Hypfer/esp8266-vindriktning-particle-sensor/(threads)

Thread 1 (2021-07-17):

Temperature and Humidity

GSzabados, 2021-07-17:
Hello,

First of all, awesome project. I didn’t even know that IKEA has an Air Quality sensor. Some might would think that they would fit inside their Air purifier first a sensor like this...

Anyhow, have you thought of adding a Temperature and Humidity sensor into the device to give a full range of environmental details? Like a DTH22 or AM2302. Is there enough space to fir that as well?

Best Regards,

Gábor

Hypfer, 2021-07-19:
As I personally already have a functioning bunch of zigbee temperature sensors basically everywhere, I did not try that, however it should be an easy modification software-wise.

As for hardware, it might get a bit too crammed in there.
Note that adding too much stuff in there might interfere with the airflow and therefore mess up the readings

GSzabados, 2021-07-19:
> Note that adding too much stuff in there might interfere with the airflow and therefore mess up the readings

Thanks for the reply. I've just had some time this morning and checked the images of the device from Twitter. I understand now what you mean regarding the airflow. Anyhow I will give it a try with a DTH22 HAT. I ordered this morning before checking the pictures. I will keep you updated how it worked out. (I might will need some help for the sketch as I don't have too much experience with it.)

Hypfer, 2021-07-19:
If you want to extend this codebase, you probably would want to do the following

Extend that state struct to also contain the data from the DHT22
https://github.com/Hypfer/esp8266-vindriktning-particle-sensor/blob/320cdc01117ec18da23eded5a7450d70119d8cdd/src/types.h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

Extend the autoconfig section to also publish temperature and humidity sensors

https://github.com/Hypfer/esp8266-vindriktning-particle-sensor/blob/320cdc01117ec18da23eded5a7450d70119d8cdd/src/esp8266-vindriktning-particle-sensor.ino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

Extend the MQTT publish function to add the other measurements to the published JSON

https://github.com/Hypfer/esp8266-vindriktning-particle-sensor/blob/320cdc01117ec18da23eded5a7450d70119d8cdd/src/esp8266-vindriktning-particle-sensor.ino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

And since the DHT22 requires polling afaik, extend the loop function to poll it on each publish

https://github.com/Hypfer/esp8266-vindriktning-particle-sensor/blob/320cdc01117ec18da23eded5a7450d70119d8cdd/src/esp8266-vindriktning-particle-sensor.ino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

That should be about it

matrob, 2021-08-16:
The additional function of the DHT22 would be absolutely great. Is anyone already working on this?

GSzabados, 2021-08-16:
> The additional function of the DHT22 would be absolutely great. Is anyone already working on this?

I went down the ESPHome way at the end as @Habbie made a ESPHome component which is/will be part of the latest release of ESPHome.

matrob, 2021-08-16:
Thank you for pointing this out. I will take a closer look at his PR https://github.com/esphome/esphome/pull/2038.

unreal4u, 2021-08-16:
Hi all!

Based on above indications of @Hypfer (hey, thanks for your work!), I created a quick-'n-dirty© commit that implements a DHT11 sensor. Please adjust accordingly if you are using the DHT22 variant :)

I connected it to D4 of the Wemos Mini, or GPIO02, adjust accordingly.

Because it is so quick and dirty, I won't create a PR: ideally I would want to define one variable in order to include all the additional information + libraries and such, but this is the first time I have played with an ESP8266 board, so I def. will have done some very wrong stuff!

The commit can be found at my fork:
https://github.com/unreal4u/esp8266-vindriktning-particle-sensor/tree/support-for-dht-sensor

To compile, you'll need the Adafruit Unified Sensor (v1.1.4) library installed. I also installed the DHT Sensor Library (v1.4.2) but I'm not quite sure if this is needed or not.

grmcdorman, 2021-12-30:
I have an alternative firmware implementation, https://github.com/grmcdorman/esp8266_vindriktning; this uses an SHT31-D (an I2C device), but it shouldn't be hard to add the DHT variants to the code base from the way I've structured it. I have it working nicely with the SHT31-D.

The Vindriktning polling in that code has been gently revised; I believe it is more robust (for example, that 25 ms wait "for unknown reasons" isn't needed any more).

Closed 2021-07-21.

Thread 2 (2021-07-17):

Crash after first reading is received

joelhaasnoot, 2021-07-17:
Thanks for this excellent work!

I tried to replicate but after receiving the first reading, the system crashes. A side-effect of this is that the Wifi Config is lost and you have to reconfigure it, making debugging a bit of a pain :)

The serial log looks like this:
```
IP: 192.168.1.239
-- Current GPIO Configuration --
PIN_UART_RX: 4
Receiving:................................................................Receiving:....................Done.
Received PM 2.5 reading: 6

--------------- CUT HERE FOR EXCEPTION DECODER ---------------

Exception (0):
epc1=0x40201673 epc2=0x00000000 epc3=0x00000000 excvaddr=0x00000000 depc=0x00000000

>>>stack>>>

ctx: cont
sp: 3ffffdc0 end: 3fffffc0 offset: 0190
3fffff50:  3ffef6a8 3ffef9a4 00000004 40201673
3fffff60:  40217c3d 0000000f 00000000 00000000
3fffff70:  3ffef6a8 3ffef720 3ffef1c0 402037cc
3fffff80:  00000000 00000000 00000001 3ffefb34
3fffff90:  3fffdad0 00000000 3ffefb20 40203800
3fffffa0:  3fffdad0 00000000 3ffefb20 40217640
3fffffb0:  feefeffe feefeffe 3ffe862c 4010156d
<<<stack<<<

--------------- CUT HERE FOR EXCEPTION DECODER ---------------
```

I've decoded the exception to be

```
Exception 0: Illegal instruction
PC: 0x40201673
EXCVADDR: 0x00000000

Decoding stack results
0x40217c3d: __delay(unsigned long) at /Users/user/Library/Arduino15/packages/esp8266/hardware/esp8266/3.0.1/cores/esp8266/core_esp8266_wiring.cpp line 55
0x402037cc: handleUart() at /Users/user/Downloads/esp8266-vindriktning-particle-sensor-master/src/esp8266-vindriktning-particle-sensor/serialCommunication.ino line 81
0x40203800: loop() at /Users/user/Downloads/esp8266-vindriktning-particle-sensor-master/src/esp8266-vindriktning-particle-sensor/esp8266-vindriktning-particle-sensor.ino line 142
0x40217640: loop_wrapper() at /Users/user/Library/Arduino15/packages/esp8266/hardware/esp8266/3.0.1/cores/esp8266/core_esp8266_main.cpp line 201
```

(using a D1 Mini Pro)
Any ideas what's going wrong?

joelhaasnoot, 2021-07-17:
Ah, took a little longer and figure it out. Once I had downgraded to ESP8266 Board/Core version 2.7.4 it works fine.

It does however still seem to constantly be losing its wifi settings.

Hypfer, 2021-07-19:
Huh. Interesting. Unfortunately, I can't say much about both of your issues since I honestly lack the experience.

Which version of ESP8266 Board/Core were you using before? Maybe there are breaking changes mentioned in the release notes between 2.7.4 and that version.

In any case lets hope that someone with the suitable skills reads this issue and shines some light on the problem

joelhaasnoot, 2021-07-21:
I used 3.0.1 before.
I think the issue may be timing related. It seems to be quite sensitive timing wise, see my other message.

joelhaasnoot, 2021-07-21:
> It does however still seem to constantly be losing its wifi settings.
This was an issue on my side

enwi, 2021-07-22:
I think both issues (#2 and #8) are related to the `parseState()` function, which was declared to return a bool, but did not return anywhere, which will result in undefined behaviour. This has been fixed with #9 and I think it is already working for @joelhaasnoot again.

https://github.com/Hypfer/esp8266-vindriktning-particle-sensor/blob/e6ff884dfb68036f855f042d9b4e05165366b09d/src/serialCommunication.ino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

Hypfer, 2021-07-23:
Thanks for figuring that out @enwi !

As I just copy-pasted most of this code from one project to another, the same issue did surface here:
https://github.com/Hypfer/esp8266-midea-dehumidifier/commit/fabc01297fe6c787b87e095390be8abcaafbc91c

I am somewhat surprised that the compiler didn't complain though

enwi, 2021-07-23:
@Hypfer C compilers can sometimes be strange. I mean I didn't even get a compiler warning, so I first thought the `memcpy` did something weird. But it wasn't until I tried to force the function to return by adding a return statement that the static analysis (intellisense) told me, hey you can't just return you need to return a boolean that I noticed it.

Closed 2021-07-24.

Thread 3 (2021-07-19):

reading calculation appears to be wrong

Habbie, 2021-07-19:
https://github.com/Hypfer/esp8266-vindriktning-particle-sensor/blob/master/src/serialCommunication.ino#L2
says

```
serialRxBuf[3] * 256 ^ 3 + serialRxBuf[4] * 256 ^ 2 + serialRxBuf[5] * 256 ^ 1 + serialRxBuf[6];
```

which I believe is equivalent to

```
serialRxBuf[3] * 256 ^ (3 + serialRxBuf[4]) * 256 ^ (2 + serialRxBuf[5]) * 256 ^ (1 + serialRxBuf[6]);
```

The code is most certainly not multiplying [3] by '256 to the power of 3', etc.

I think the right code would be

```
serialRxBuf[5] * 256 + serialRxBuf[6];
```

based on page 7 of http://www.jdscompany.co.kr/download.asp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

Hypfer, 2021-07-19:
Ah yes I was somewhat suspecting that that could be wrong but did work anyways as during normal operation only the last byte actually contains data.

Adding [3] and [4] to the sum as well was taken from the [datasheet of the PM2107](https://9b54c437a0e032d4eb32-010f1da83de0c62ea8c11f5612b46edb.ssl.cf3.rackcdn.com/Cubic_PM2107_DS.pdf) as I did only find a different datasheet for the PM1006K which used a different poll command than the one for the PM1006.
By googling for "11 02 0b 01 e1", the PM2107 turned up.

Measurements would be absurdly high to exceed those two bytes though so it makes sense that they've dropped(?) that

Habbie, 2021-07-19:
Yep - the wrong code effectively adds 2 to the measurement I think, which is not an error that stands out! I did also find the PM1006K - at least that explains why the string is so long for just 2 bytes of data :-)

Habbie, 2021-07-19:
Commit looks good, thanks for the quick response!

Hypfer, 2021-07-19:
I can't help but wonder what the other data fields might contain 🤔

I did plot DF9-DF12 for a while and got basically the same curve as the PM2.5 reading albeit offset by around 20 μg/m³ so I'd suspect that that's some kind of raw uncalibrated value or similar.

DF5-DF8 are mostly constant during my observations

Habbie, 2021-07-19:
Yes, me too! I did not plot them but I do have this small collection of dumps

```
16 11 0b 00 00 00 17 00 00 06 9f 00 00 00 16 01 00 00 00 fb

16 11 0b 00 00 00 19 00 00 06 a4 00 00 00 18 01 00 00 00 f2

16 11 0b 00 00 00 18 00 00 06 a3 00 00 00 17 01 00 00 00 f5
```

(I used these to implement checksumming, not for anything else).

The offset in these 3 readings is 1, not 20.

I also note that the PM1006K, which does have PM10 and PM1.0, still has a shorter string!

Habbie, 2021-07-19:
Going even more off topic, you inspired me to do https://github.com/esphome/esphome/pull/2038, with credit to you in the comment there, and in the docs content at https://github.com/esphome/esphome-docs/pull/1315

Hypfer, 2021-07-20:
This might also be interesting for @GSzabados #1

GSzabados, 2021-07-20:
Thanks @Hypfer, and @Habbie that is awesome work. I haven't started to use EspHome yet, but that will make things far more easier.

Hypfer, 2021-07-20:
If only ESPHome wasn't using yaml and this weird web thing :(

GSzabados, 2021-07-20:
> If only ESPHome wasn't using yaml and this weird web thing :(

Sure thing, but with a HA installation it makes things kinda plug and play.

blakadder, 2021-08-28:
https://en.gassensor.com.cn/Product_files/Specifications/LED%20Particle%20Sensor%20PM1006K%20Specification.pdf

Habbie, 2021-08-28:
The sensor in the IKEA VINDRIKTNING is the PM1006, not the PM1006K.

Closed 2021-07-19.

Thread 4 (2021-07-20):

Not an issue - just a question! ZigBee instead?

LaurenceGough, 2021-07-20:
Hi, thanks for the project, very clever idea, and an interesting device.

I did purchase one of these sensors today, I didn't even realise it had a fan, quite a noisy one at that! You're right, without the fan operating such as generating some smoke behind it it doesn't detect it at all, but as soon as the fan turns on it does just fine. I do wondering if lowering the voltage on the fan gives the same accuracy, because I sure am tempted! Doing some very caveman style testing shows it's very accurate so far.

There is some interesting info on the sensor if it is this one. Interesting the range of PM it can detect, not just 2.5um particles, unless this is a custom modification made! I wonder if it can detect grass pollen at around 20um
https://pdf.directindustry.com/pdf/cubic-sensor-instrument-co-ltd/pm1006k-led-particle-sensor-module/54752-927719-_4.html

Anyway, onto my question - if I wished to do a similar mod but using ZigBee (Smartthings hub) rather than WiFi would you have any suggestions?

This devices begs for smart connectivity, I can't believe Ikea did not do this with their already established ZigBee range!

There is nothing wrong with WiFi of course, it'd work great. I'm just a fan of ZigBee for low data rate/low powered devices.

Many thanks

Hypfer, 2021-07-20:
I'm not aware of any zigbee-capable uCs that are as easy to work with as the esp8266.
I'm sure that there must be _something_ but it will either be expensive or hard to work with or maybe even both.

This is made worse by the fact that the SmartThings Hub is a proprietary thing which you cannot extend and/or debug in any way.
It wouldn't surprise me if they also have a whitelist of allowed devices.

I am not an expert on zigbee devices, however looking at both the [ZCL](https://www.nxp.com/docs/en/reference-manual/ZCLRM.pdf) as well as the [ZHA](https://www.nxp.com/docs/en/user-guide/JN-UG-3076.pdf) spec there doesn't seem to be some existing structure for air quality measurements.

If I understand it correctly, in theory it should be possible to extend ZCL with custom functionality. However as you don't control the code of your Zigbee coordinator, this is definitely impossible.

MattWestb, 2021-08-29:
Sorry for jumping in but Starkvind that is being reeled in October is having one Zigbee module (the new EFR32MG21) and the OTA firmware is released and can being flashed on other EFR32MG21 devices.
I see 2 version they can have doing it:
1. Using the vindriktning PCB and the debug connection for "sniffing" the sensor and using the fan connection (not populated on the PCB) for steering the fan speed (if not loading one different firmware in the MCU).
2. Making one new PCB and have connecting the sensor to it and have one power supply and circuits for PWM steering of the fan (for the purifier) and also the steering knob and is using the Zigbee module MCU for doing all work.

Very likely they have implanting the Zigbee cluster for all relevant data transmitted to there host system and the RX from the sensor and perhaps sending the commands for doing the measuring if not using the vindriktnings PCB.

Closed 2021-07-24.

Thread 5 (2021-07-20):

Not an issue but a suggestion: Merge into Esphome?

oopsitsaflame, 2021-07-20:
Hi, would it be possible to get this device supported into esphome? I think it would fit quite good as a supported sensor and you would get all the other stuff esphome supports as a bonus.

Hypfer, 2021-07-20:
@habbie already did that
See https://github.com/Hypfer/esp8266-vindriktning-particle-sensor/issues/3#issuecomment-882858203

Personally, I don't use ESPHome due to philosophical differences.

Hypfer, 2021-07-20:
Just for reference, I'd like to mention that decentralization is a good thing.
We shouldn't be merging everything into a single yaml behemoth.

Nabu Casa is slowly eating the smarthome world which by definition is a bad thing even though their intentions are most likely good.
We need better solutions to eliminating boilerplate code than merging everything into a single legal entity.

oopsitsaflame, 2021-07-20:
Just for reference too ;) I'd like to mention that while your concerns are understandable., I just like not having to rely on projects where I have to search half the internet for and then to discover that the one dude/duddette who  maintained it alone has last logged in 4 years ago. (not talking about you, but in general). Open source can help with both these problems but not eleminate them completely.
https://xkcd.com/2347/

Closed 2021-07-20.

Thread 10 (2021-07-21):

Question about wiring points

wizbowes, 2021-07-21:
The photo you have of the wired up test points, you seem to have the data wire connected to the test point labelled 'REST'.  Just confirming that this is correct.  Isn't REST a reset line of some kind, and the far left test point labelled ISPDA the data test point?  Or is the board labelling incorrect.  Don't have a scope so can't really check myself...

Hypfer, 2021-07-21:
Yes that is correct.

The board looks like it might've also been used in a different configuration. I suspect that that's why the label isn't UART_TX or something like that.

trejan, 2021-07-23:
The labels don't match normal operation functions because those test points are for in-circuit programming of the uC. It needs ISPCL, ISPDA, MRSTN (REST), VDD and VSS which are all present in that row. The MRSTN pin is configured to be UART RX.

drthanwho, 2023-01-15:
Is there any chance that by accidentally first using ISPDA instead of REST that the board was damaged? I confused myself and connected D2 to ISPDA, realised because was getting an `unknown` value, connected it to REST but still getting no values

Closed 2021-07-21.

Thread 6 (2021-07-21):

Not an issue: but a link to the actual PM1006 datasheet

theOzzieRat, 2021-07-21:
Cubic's website sucks and it doesn't make it clear that there are both PM1006 and PM1006K versions of the sensor that pretty much look identical. I found a link to the PM1006 datasheet which appears to match the data that I have seen posted elsewhere.
The PM1006 only does pm2.5 :(

[(http://www.jdscompany.co.kr/download.asp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)]

Closed 2021-07-24.

Thread 7 (2021-07-21):

Not an issue - A little more information about the fan

sermayoral, 2021-07-21:
Hi. First of all, thanks for this amazing project! I really want to do it, and during the analysis, I had some questions regarding the fan.

If I understand correctly, the firmware of the Ikea board toggle the fan every minute. Surely the firmware does a reading with the fan on. The doubt is the next one: If you replace the 5v output of the ikea board for the 3v3 output of the esp. Does the toogle function hold? Or would you have a fan that is always running?

Thanks

Hypfer, 2021-07-21:
That results in the fan running constantly as it completely bypasses the FAN outputs of the Ikea PCB

sermayoral, 2021-07-21:
Thanks @Hypfer.

What do you think about applying a step down to the FAN outputs of the Ikea PCB in order to reduce voltage to 3.3V? In that way the toggle function should work.

Hypfer, 2021-07-21:
That would require more hardware. The permanent 3.3V were just there for the taking
I wasn't able to spot any downsides of running the fan continuously

Actually I'm more worried about the 5V UART to the 3.3V ESP8266 regarding long-term reliability
Only time will tell

sermayoral, 2021-07-21:
Thanks @Hypfer for the information. I will test with the step down and I will share the results here :-)

Habbie, 2021-08-16:
> Actually I'm more worried about the 5V UART to the 3.3V ESP8266 regarding long-term reliability

I did extensive Googling on this and it appears the ESP8266 UART is 5V safe for receiving.

trlafleur, 2021-10-02:
I use a ~470ohm resistor from the IKEA to the Wemos-D1 Mini pin D7 (GPIO-13) with a surface mount Schottky diode (they have a low V-Forward drop) from D7 with its cathode connected to +3.3v, this clamp the voltage to 3.3V + V-forward drop of the diode... this makes it safer for the ESP8266 (I now see 3.7V on my unit on D7)... Using pin D7 makes it an easy fit for the diode to 3.3v pin on the Wemos-D1 circuit board. ( 3.3v - D8 - D7 ......) so the diode is set on top of D8, with just enough room to solder it to 3.3V and D7.

onshisan, 2022-01-01:
> Just as a note: I move my unit from this codebase to Tasmota

Sounds great, I was also thinking of adding more so I'm curious... any notable issues to report using Tasmota to accomplish this?

trlafleur, 2022-01-01:
useing an esp32, works just fine....

~~ _/) ~~~~ _/) ~~~~ _/) ~~~~ _/) ~~

Tom Lafleur

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

Thread 12 (2021-07-24):

Potential problem with running the fan at 3.3V?

Leeev, 2021-07-24:
I think there may be an issue with running the fan at 3.3V.
At 5V the fan will push a certain CFM for certain amount of time.
At 3.3V the fan will push much less CFM for that time.
The sensor unit counts the number of particles that are pushed though it in that time.
Net result, the sensor will see many less particles (due to less volume of air passing through it) and will under report the air quality.

Hypfer, 2021-07-24:
> The sensor unit counts the number of particles that are pushed though it in that time.

Nope. It counts the particles in the air that it sees. As they are distributed evenly in every m³ of air, the measurement is not impacted. At least I couldn't see any difference in readings when put side by side.

It is possible that the sensor will react slightly slower to changing conditions though, as on change, the new amount of particles may not be distributed as evenly. That however is a temporary state that resolves itself pretty quick.

Hypfer, 2021-07-24:
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

It is still rather quick to react IMO. Someone in the neighbourhood started to burn something just now

Leeev, 2021-07-27:
I see what you're saying, but I think you may be incorrect. The firmware in the unit is calibrated to a full fan speed.
At full speed the fan could move, say, 100cm3 of air through the unit, in say,10 secs. If there are 1000 particles in that 100cm3 of air the unit will register 1000 particles.
If the fan is working at 3.3V, it will move, say, 2/3 of that 100cm3 of air through the sensor in those 10 secs and therefore only register 666 particles.
This would suggest that the air is 'better quality' that it really is?
I'm not say it won't work, but rather the data will be low/incorrect.

Hypfer, 2021-07-27:
As discussed on hackaday I'd argue that that is not the case as there is no mention of the fan and/or its requirements in the datasheet of the sensor.

The fan is not part of the sensor but something that was bolted on by Ikea.
Therefore, I find it hard to believe that anything _inside_ the sensor depends on something purely external

Closed 2021-07-24.

Thread 13 (2021-07-26):

increase max mqtt password

itsme9, 2021-07-26:
hi, could you increase the max mqtt password from 24 to 32 chars please?
I tried to do it myself but get: "Socket error on client <unknown>, disconnecting" in Home assistant so I probably messed it up.
Thanks

binaryhellstorm, 2021-12-29:
Same issue. My password get's truncated after the first 24 characters

onshisan, 2022-01-01:
Also came here to request this. My use case is [Adafruit.io](https://io.adafruit.com/api/docs/mqtt.html#client-libraries) where a 32 char key is used as MQTT password.

Thread 15 (2021-07-30):

UART levels 5V / 3.3V

bertmelis, 2021-07-30:
You write in your readme `"ESP8266 is 5V-tolerant, this should there shouldn't be any issues"`. This is not true of course. Anything aboce 3.6V can damage the pins.

Since the UART level of an PM1006 is I do expect issues with burning pins on the ESP8266.

Maybe the IKEA board has a level shifter? Did you find one?

Hypfer, 2021-07-30:
> This is not true of course. Anything aboce 3.6V can damage the pins.

https://twitter.com/ba0sh1/status/759239169071837184

https://hackaday.com/2016/07/28/ask-hackaday-is-the-esp8266-5v-tolerant/

bertmelis, 2021-07-30:
🤯

Hypfer, 2021-07-30:
I'm actually curious if there are any long-term side-effects. As of now I haven't seen any but that doesn't mean much

bertmelis, 2021-07-30:
Went to Ikea yesterday, hacking this evening. I might throw in a voltage divider though, just to be sure. I'm short on devices atm.

bertmelis, 2021-08-05:
so I tried with a simple voltage divider (2k2, 3k3) and this happens:
it works when I power the whole module via the Wemos D1 it works flawlessly. When I power via the main USB-C port it doesn't work. That is: it does connect to MQTT but the SoftwareSerial doesn't detect anything.

My electronics skills are a bit rusty. Would you have a clue?

bertmelis, 2021-08-05:
Nevermind. Got it. I guess I ruined a path when soldering.

I used another pin and now it works without a problem.

bilogic, 2021-11-17:
I did some googling.

For folks like me who are not hardware savvy, the term 5V tolerant may be interpreted as being able to use 5V to power the chip, i.e. directly wire the USB power to ESP8266's 3.3V

But that does not seem to be the case as clarified by the CEO of Expressif here https://www.facebook.com/groups/1499045113679103/posts/1731855033731442/?comment_id=1732364133680532

- 5V I/O - ok
- 5V power - not ok

It might be better to state that clearly: `As the ESP8266 I/O pins are 5V-tolerant, this should there shouldn't be any issues...`

Thanks.

LordPinhead, 2021-11-17:
Hi, so that's a true and false thing. The chip itself is not 5V safe, you have to use a regulator of some kind. But the D1 has  this on board.
If the regulator is not damaged, you can power it safely with USB. If its damaged though, you could destroy the chip.

I ordered 10 D1 Mini from Aliexpress and they were all goners, 1 from Germany that works without a hitch.
I measured the Vin  of the ESP and it had between 1 and 3 Volts jumping or worse, 5V directly.

So a few are really gone, a few I could maybe safe when use a buck converter. But it's true that the esp chip itself will die with more than 3.6V in.

You know its dead when you flash the sketch and it constantly reboots with strange exceptions. Measure VIN on the esp and see if the regulator of the board is toast.

bilogic, 2021-11-17:
I commented earlier because I almost connected 5V to my 3.3V rail before "common" sense kicked in and I googled. I'm sure some have blown their ESP8266 due to misinterpreting "5V tolerant".

Even if some ESP8266 can endure the 5V, most won't. All I'm trying to do here is to prevent more damage.

Closed 2021-07-30.

Thread 16 (2021-08-02):

Many readings of zero, leading to few messages

brev-dev, 2021-08-02:
Great work on this mod, thanks @Hypfer!

I've now tried it with two sensors. One works flawlessly, reporting regularly over MQTT. The other is quiet for long periods of time, only occasionally reporting a reading. Over serial, I see that many of the measurements are zero (and the code won't publish unless the average reading is greater than zero).

At first I thought it was either a dead sensor, or a hardware issue with my mod. But if I hold a match next to the sensor, the light changes to yellow and red, and the reported numbers increase. MQTT messages are then sent until the smoke dissipates, the sensor returns to green, and the numbers reduce to zero again.

So what's going wrong? Bad sensor? Acceptable calibration differences between sensors, which need to be handled differently in the code? With a sample size of 2, I don't have enough to go on.

For now, I'm going to remove the "don't publish if zero" line in the code, set the two devices next to each other, and set-up logging of the MQTT messages to see if this sheds any light on the behavior.

Hypfer, 2021-08-02:
Interesting report.
Honestly, I have no idea whether or not 0ug/m³ is a plausible reading or not, however that check was only there because I didn't know that there was a checksum in there to ensure that we only store valid readings.

As that has been added with https://github.com/Hypfer/esp8266-vindriktning-particle-sensor/commit/04701b28db4d816c9ff1e639ea4a1adae00e755d, all those > 0 checks are obsolete and can be removed I think

brev-dev, 2021-08-02:
Thanks again - I'll give it a try!

brev-dev, 2021-08-03:
OK, here are some side-by-side tests. For the "problematic" Device1 (red curve), I removed two of the zero checks in the code (one in the check loop, and one in the average calculation in `SerialCom.h`). The "behaving" Device2 (green curve) uses your code unchanged.

The first image shows an ambient overnight test. Device1 produced nothing but zeros all night.

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

For the second image I placed both devices under a plastic cover (maintaining the [Ikea theme](https://www.ikea.com/no/no/p/krispig-kaketine-20336407/)), and added a bit of smoke. Both devices color-cycled from green to red and back, with Device1 transitions consistently trailing Device2 as the air quality worsened, and leading Device2 as the quality improved (as an aside, it looks as though the transitions are at about 30 and 100ug/m³).

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

Conclusions... I suspect both devices are "working", at least for the intended purpose of a rough traffic-light air quality display. And they'll be fine for me, too. The absolute values they report are quite different, though. I haven't looked into data sheets, but maybe there's a way to calibrate the sensor if it matters to your use case.

In terms of the mod, yes, I suggest you remove the zero-checks, as long as it doesn't break anything else!

Hypfer, 2021-08-03:
I wonder if one could implement an auto calibration algorithm similar to what is used in some CO2 sensors:

https://www.monnit.com/support/knowledgebase/sensors/co2-auto-calibration-feature/

TL;DR:
It takes the lowest reading during a long interval (multiple days) and assumes that that must be a specific value (400ppm).

pejotigrek, 2021-08-21:
I know this issue is closed, but I just wanted to give you measurements for transitions, just in case they're needed somewhere - according to the user guide attached to my Vindriktning sensor here they are:

- green: 0-35 (good+low)
- orange: 36-85 (OK+medicore)
- red: 86-... (bad+high)

Closed 2021-08-03.

Thread 17 (2021-08-03):

Possible improvement: sample size of 7

bertmelis, 2021-08-03:
My sensor works in bursts of 7 samples with +/- 2 seconds in between, followed by a 10 seconds pause.

does this differ from yours?
is there a reason you use an average of 5 samples?

bertmelis, 2021-08-04:
Fair enough, I was just wondering.

Closed 2021-08-04.

Thread 18 (2021-08-04):

Control LED? Night mode?

fabiosoft, 2021-08-04:
Did you find same traces for LED controlling? I can see some pins labelled LED_G and LED_R...but i can't figure out what's the purpose and if i can use GPIO or need a relay... btw where is the Yellow? 🤣

Maybe could be useful in bedrooms during the night (too tiny space to add a photoresistor too?)

Hypfer, 2021-08-04:
There already is a light sensor for automatic dimming in place, however even in the "dim" state, the LEDs are still way too bright IMO.

I've mitigated that issue with my sensors by taking a black permanent marker and adding a few layers of paint to the LEDs.
They're still a bit too bright though

fabiosoft, 2021-08-04:
So next step... cut out uC for led 😇  ...and use pins and transistors/relays to control colors with a rule based on epa rules (already followed by original fw) [AIR QUALITY STANDARDS (page 4)](https://www.epa.gov/sites/default/files/2016-04/documents/2012_aqi_factsheet.pdf)

brev-dev, 2021-08-05:
I believe the image below shows the resistors corresponding to the LED pairs (greens are in parallel with two resistors; red and yellow are in series, with one each). So you should be able to tweak their values to reduce the offensive glare. I've popped-off R9 as a quick way to halve the green output. The least destructive alternative might be to shove some paper behind the frosted window.
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

mcodebase, 2023-04-09:
Hi,
I try the solution from SnowHead (add a resitor in parallel to R8 (22k)),
this resistor will be reduce the brightness when it's bright to the "dark" mode.
But no chance to reduce the "dark mode" darker ...

My question, is there a Pin or an option to cut a ciruit path physically, so the LED will be completly "off".
My idea is to add a switch or relay so the Vindrikning is completly dark in the night (but still woking).

xSnowHeadx, 2023-04-11:
There is no simple solution for that. You only can switch the LED completely off by removing the connections of the red and green LED to the positive voltage and of the orange LED to ground by scratching the copper lines and using a dual poled switch to reconnect them on demand.

dudzio12, 2024-11-07:
@mcodebase have you found any solutions? :)

Thread 20 (2021-08-07):

Not an issue - Video on how to convert and setup the particle sensor

enwi, 2021-08-07:
Hey @Hypfer I made a video on how to convert the Vindriktning sensor and how to set it up. I you want you can add it to the readme, as it will go through all the needed steps. There is also a German version of the video, which is also linked from the English version 😄
https://www.youtube.com/watch?v=NwHL8XMarFY

Hypfer, 2021-08-07:
https://github.com/Hypfer/esp8266-vindriktning-particle-sensor/issues/15#issuecomment-889892467

enwi, 2021-08-07:
I would still go for the extra protection using the voltage divider, as I remember correctly I killed an ESP8266 before supplying 5V to a GPIO. So better stay on the safe side.

Q7Jensen, 2021-08-08:
When the device is configured, how can I reconfigure it a second time to select another mqtt broker?

enwi, 2021-08-08:
@Q7Jensen that's still a [todo](https://github.com/Hypfer/esp8266-vindriktning-particle-sensor#todo)

Thread 23 (2021-08-11):

get no values from sensor

caveman2003, 2021-08-11:
Hi all,

after install and successful upload to wemos i can see messages in MQTT Explorer but no values ... i just see:
```
{
  "device": {
    "identifiers": [
      "VINDRIKTNING-49ED42"
    ],
    "manufacturer": "Ikea",
    "model": "VINDRIKTNING",
    "name": "VINDRIKTNING-49ED42",
    "sw_version": "2021.08.0"
  },
  "availability_topic": "esp8266-vindriktning-particle-sensor/VINDRIKTNING-49ED42/status",
  "state_topic": "esp8266-vindriktning-particle-sensor/VINDRIKTNING-49ED42/state",
  "name": "VINDRIKTNING-49ED42 PM 2.5",
  "unit_of_measurement": "μg/m³",
  "value_template": "{{value_json.pm25}}",
  "unique_id": "VINDRIKTNING-49ED42_pm25",
  "icon": "mdi:air-filter"
}
```
i would expect to see some values in "value_template" and not  "{{value_json.pm25}}"... i would say i solder correctly on the board ... also i tested with PIN_UART_RX = 5 in SerialCom.h but the same output ... is my wemos maybe brocken ?
any ideea?

Thanks ....
GREAT IDEEA :-)

caveman2003, 2021-08-11:
or would i see an value here only if the sensor detect something? i tried so simulate some "dust" but LED is still green :-)

brev-dev, 2021-08-13:
Issue [#16](https://github.com/Hypfer/esp8266-vindriktning-particle-sensor/issues/16) might be relevant for you. It seems some sensors are calibrated such that for most of the time they only produce zeros. To debug what's happening in your case, I suggest you focus on seeing what happens when the color is changing on the device: when the device is turning to at least yellow, that's your independent verification that the wemos should be detecting valid readings.

Dust might be too coarse-grained. Blow some smoke over it, from a match for example. Stick it under a bowl if you want the smoke to linger.

caveman2003, 2021-08-16:
Hi brew-dev,

thanks for the hint with the match ... :-) bad that i'm not smoking ... but an small piece of paper produce also some smoke :-)

the esp8266 was broken after changing the device i get:

`{
  "pm25": 1000,
  "wifi": {
    "ssid": "xxxxx",
    "ip": "192.168.xxx.yyy",
    "rssi": -77
  }
}`

So it works perfectly!!!  THANKS!!

caveman2003, 2021-08-16:
closing

Closed 2021-08-16.

Thread 24 (2021-08-13):

which libraries to use? Just a question.

MHz000, 2021-08-13:
- working with VScode I'm insecure which libraries to use.
lib_deps =
	bblanchon/ArduinoJson@^6.18.3
	tzapu/WiFiManager@^0.16.0
	knolleary/PubSubClient@^2.8

- Config.h,Types.h and SerialCom.h already in scr folder but "compilation terminated ... include files not found"

- besides the 3.3V issues would an ESP-01 be sufficient
Thank-you for advice

LordPinhead, 2021-11-06:
When you open the Sketch in Arduino Studio and import the sketch (ino) it says the sketch has to be in a subfolder, then it creates the subfolder and moves the Ino file into it. So "src/esp8266-vindriktning-particle-sensor.ino" will become "esp8266-vindriktning-particle-sensor/esp8266-vindriktning-particle-sensor.ino" and then the files have to be copied over to the folder.

That helps with that issue.

zfsnotification, 2022-02-13:
I can't get past SerialCom.h not found  I have a copy in every folder

Thread 27 (2021-08-23):

platformio: section `.text' will not fit in region `iram1_0_seg'

datanizing, 2021-08-23:
Fantastic project, but I can't manage to compile it with PlatformIO:

```platformio run
Processing d1_mini (platform: espressif8266; board: d1_mini; framework: arduino)
----------------------------------------------------------------------------------------------------------------------------------------------------------
Verbose mode can be enabled via `-v, --verbose` option
CONFIGURATION: https://docs.platformio.org/page/boards/espressif8266/d1_mini.html
PLATFORM: Espressif 8266 (1.5.0) > WEMOS D1 mini
HARDWARE: ESP8266 80MHz, 80KB RAM, 4MB Flash
PACKAGES:
 - framework-arduinoespressif8266 1.20300.1 (2.3.0)
 - tool-esptool 1.409.0 (4.9)
 - toolchain-xtensa 1.40802.0 (4.8.2)
Converting esp8266-vindriktning-particle-sensor.ino
LDF: Library Dependency Finder -> http://bit.ly/configure-pio-ldf
LDF Modes: Finder ~ chain, Compatibility ~ soft
Found 26 compatible libraries
Scanning dependencies...
Dependency Graph
|-- <ArduinoJson> 6.18.3
|-- <PubSubClient> 2.8.0
|-- <WiFiManager> 0.16.0
|   |-- <DNSServer> 1.1.0
|   |   |-- <ESP8266WiFi> 1.0
|   |-- <ESP8266WebServer> 1.0
|   |   |-- <ESP8266WiFi> 1.0
|   |-- <ESP8266WiFi> 1.0
|-- <EspSoftwareSerial>
|-- <ArduinoOTA> 1.0
|   |-- <ESP8266WiFi> 1.0
|   |-- <ESP8266mDNS>
|   |   |-- <ESP8266WiFi> 1.0
|-- <DNSServer> 1.1.0
|   |-- <ESP8266WiFi> 1.0
|-- <ESP8266WebServer> 1.0
|   |-- <ESP8266WiFi> 1.0
|-- <ESP8266WiFi> 1.0
Building in release mode
Compiling .pio/build/d1_mini/src/esp8266-vindriktning-particle-sensor.ino.cpp.o
Linking .pio/build/d1_mini/firmware.elf
/PATH_TO_LD/ld: .pio/build/d1_mini/firmware.elf section `.text' will not fit in region `iram1_0_seg'
collect2: error: ld returned 1 exit status
*** [.pio/build/d1_mini/firmware.elf] Error 1
```

What could be wrong?

Thread 28 (2021-09-21):

[question] some success with ESP32?

Kugeleis, 2021-09-21:
I soldered the VINDRIKTNING to a ESP32 board (ESP32-MINI) but do not get a signal from the sensor. a
An additional DHT11 works well. I compiled tasmota32 with the #define USE_VINDRIKTNING option and wired REST to GPIO17.
Any recommendations?

hmax42, 2021-09-30:
i used it with an esp32 (m5stamp) with esphome (pin 21) yesterday and it works

Thread 36 (2021-11-06):

Sporadic crashes when Wifi wants to connect

LordPinhead, 2021-11-06:
Hi,

I have the issue that the D1 mini is crashing at this line:

` wifiManager.autoConnect(identifier);`

Stack Decoding says:

```
Exception 0: Illegal instruction
PC: 0x40251220
EXCVADDR: 0x00000000

Decoding stack results
0x40100848: ets_post(uint8, ETSSignal, ETSParam) at /home/.arduino15/packages/esp8266/hardware/esp8266/3.0.2/cores/esp8266/core_esp8266_main.cpp line 181
0x40100848: ets_post(uint8, ETSSignal, ETSParam) at /home/.arduino15/packages/esp8266/hardware/esp8266/3.0.2/cores/esp8266/core_esp8266_main.cpp line 181
```

Now that is odd, I've installed the WifiManager in the particular version and in the one from plattform.ini, the Boards are from the latest 3.0.2 version, I've selected the "Lolin (Wemos) D1 Mini (clone)"

LordPinhead, 2021-11-07:
Never mind, I ordered 10 boards from Aliexpress and 9 are broken. I flashed one successfully multiple times and it works.

Closed 2021-11-07.

Thread 37 (2021-11-12):

Spikes

loresupercap, 2021-11-12:
I have some unwanted spikes in value signal.
Using it with MQTT/Homeassistant. Any suggestion on how to solve or the reason of those spikes?

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

LordPinhead, 2021-11-14:
I didn't have these ones so far. Could a piece of dust get into the sensor? Or this looks like around noon or after, could it be you've cooked? I baked and cooked some time ago and the sensor went off on that.

Thread 38 (2021-11-14):

Control LED

daniel-hofer, 2021-11-14:
Thank you for the great project.
The design of the device is very clean and I think about to use it as an cheap status light for home automation like homeassistant.
Ist it possible to control the LED colors without the particle-sensor - only to switch the colors with mqtt?
Best regards
Daniel

LordPinhead, 2021-11-14:
In theory, when we dump the transmission pin, but why, this is against the idea of the project.

daniel-hofer, 2021-11-14:
I don't want to ask for anything against the idea of the project.
I was looking for cheap and easy to use visualistaion devices. The Vindriktning is available in local stores and looks nice. Why not use it as an Reminder like - red light -> you got an email oder the laundry is finished and maybe blink-codes and so on.
I know, a simple rgb-LED on an esp8266 is an option, but so you need a case and led-diffusor-panel and so on.
I hope i could figure out my intention.

LordPinhead, 2021-11-15:
Hm, at first thoughts, you would need to proxy the sensor and sent in your own particle data. Driving the LED itself could work too, but I have no spare one to have fun with. Maybe check the LED, and it's power with an Oscilloscope.

bvkrieken, 2021-12-20:
@daniel-hofer
Take a look at this project:
https://www.fabiosoft.com/2021/12/02/ikea-hack-making-the-air-quality-sensor-vindriktning-smart-sensor/

Thread 39 (2021-11-14):

After connecting to personal WiFi an AP is still present

aichii88, 2021-11-14:
Hi,

thanks for this cool project! Everything is working fine up to now, but:
After the esp connects to my WiFi, still an AP is present! It changes the name from "Vindriktning-XXX" to "ESP-XXX".
How can I suppress this AP?

Br,
Michael

LordPinhead, 2021-11-15:
This should not happen, the Config seems to not load correctly. You could add some serial log entries into the sketch and print the settings over the serial monitor.

aichii88, 2021-11-21:
I implemented following work around:
Wifi.mode(WIFI_STA);

Thread 40 (2021-11-17):

Is ESP8266 module (not D1 mini) 5V tolerant?

bilogic, 2021-11-17:
Hi @Hypfer,

The readme says ESP8266 is 5V tolerant, is that true? i.e. I can connect 5V to ESP8266's 3.3V VDD
Or was it referring to the Wemos D1 mini being able to accept 5V?

Thanks!

Hypfer, 2021-11-17:
https://github.com/Hypfer/esp8266-vindriktning-particle-sensor/issues/15#issuecomment-889892467

Closed 2021-11-17.

Thread 41 (2021-11-22):

Received message with invalid header.

CountOlaf87, 2021-11-22:
Hi,

I have uploaded to a D1 Mini, it connects to my wifi, I get the status Online message in MQTT, together with the air filter and wifi message, however, it doesn't show any values in MQTT and I can't see it in Home Assistant. When I look at the Serial output of the arduino IDE, I get this messag: "Received message with invalid header."

Occasionally it does show a reading:

Received PM 2.5 reading: 42
Current measurements: 42, 39, 39, 40, 40

Thanks in advance

wvtbg, 2021-11-23:
This is shown when the data received from the particle meter is not as expected. Is your soldering correct and reliable?

rublinetsky, 2021-12-19:
I was having the same problem - I was getting the value from the sensor only in about 10% of tries. The rest were "Invalid header".

I've redone my wiring very carefully, tried using a voltage divider on the TXD2 pin, and tried to play with the magical delay(**15**) value (https://github.com/Hypfer/esp8266-vindriktning-particle-sensor/blob/83fd7c5034cc9737b954c5625426563492d83a2c/src/SerialCom.h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). Nothing helped.

Then I realized that I don't understand why we are clearing the receiving buffer in the middle of the receiving process (lines 92-94 in SerialCom.h). I commented this part out (along with the delay(15)) and it improved a lot - I am receiving reasonably looking values in more than 80% of attempts.

Can someone explain please why we are clearing the buffer?

Thanks!

rublinetsky, 2021-12-20:
I had the same problem using ESP32 and the Hardware Serial2.

The problem is caused by the fact that, depending on how often you poll the sensor library (`SerialCom::handleUart(state)`), `serialRxBuf`receives multiple messages at a time (20 bytes each) and their combined length is often over 64 bytes. For example, I've just received `16 11 0B 00 00 00 31 00 00 03 9A 00 00 00 2F 01 00 00 00 D0 16 11 0B 00 00 00 32 00 00 03 9B 00 00 00 30 01 00 00 00 CD 16 11 0B 00 00 00 33 00 00 03 9E 00 00 00 31 01 00 00 00 C8 16 11 0B 00 00 00 33 00 00 03 9F 00 00 00 31 01 00 00 00 C7 16 11 0B 00 00 00 33 00 00 03 9F 00 00 00 31 01 00 00 00 C7 `, which is 5 messages in a row.

The code
https://github.com/Hypfer/esp8266-vindriktning-particle-sensor/blob/83fd7c5034cc9737b954c5625426563492d83a2c/src/SerialCom.h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
clears the buffer after 64 bytes thus deleting three whole messages (3 x 20 bytes) and the 4 bytes of the next message. What is left is not a valid message because the header was chopped off.

Anyway, the fix seems to be replacing the loop
https://github.com/Hypfer/esp8266-vindriktning-particle-sensor/blob/83fd7c5034cc9737b954c5625426563492d83a2c/src/SerialCom.h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

with

```c++
while (sensorSerial.available() && rxBufIdx < sizeof(serialRxBuf))
{
    serialRxBuf[rxBufIdx++] = sensorSerial.read();
    Serial.print(".");
}
```

Works fine for me after this change. I've not created a pull request because I am not sure why the author used this clearing of the buffer in reading process - probably there is a good reason that I don't see.

Volcano-28, 2021-12-30:
I had the same problem. I tried to reupload sketch several times, but the problem was in incorrect configuration to the Home Assistant (mqtt). After reuploading the sensor didn't create AP again (allowing to reconfigure settings).
As I saw the mqtt configuration is stored in the flash and used even if I reupload  the sketch.
The solution is to erase the flash, like described here:
https://github.com/Hypfer/esp8266-vindriktning-particle-sensor/issues/20#issuecomment-950218909

DanielVieites93, 2023-12-04:
Hi everyone,

I'm using wemos D1 and i'm receiving this data from serialRxBuf from vindriktning:

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

I already try to use the sigention from @rublinetsky but still not working...
 Can you please help me?

Thread 43 (2021-12-05):

Not an issue, you probably need to clean the sensor regularly

hb020, 2021-12-05:
Situation: vindriktning with small self-made esp8266 board that sends the values to my IOT system. Readout function based on this git.
Over the last 2 months the pm2.5 values have been (on average) nearly linearly increasing, up to the point where it was 140 ppm average, and red all the time. I opened up the box, found that the small filter on the sensor was all clogged up. Gave it a gentle blowout with the air compressor (yes, I protected the fan). Started all up again. The first 4-5 hours it did not seem to make any difference. But then suddenly there was a 100 ppm drop, followed by a drop of 30 more 1 hours later. Both drops were while we were out, nothing happened in the house, the device did not reboot.

It reacts to our presence, so it is not dead, and now it is back to levels where it was when I just bought it.
So either I damaged it, or the sensor really sensitive to dust accumulation on the sensor. I tend to believe the latter.

Maybe others also see that nearly linear increase over time? That could confirm my suspicion.

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

Baxxy13, 2021-12-12:
After reading this i opened my 2 sensors and removed the dust from the small intake filter.
The measured values are now much lower, like time of first installation 3 months ago.
Thanks for the tip!
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

hmax42, 2022-03-08:
i have the same behavior on my 2 units
i power cycled them yesterday, which didnt happen for nearly 40 days
and the readings are back to normal

hb020, 2022-04-14:
indeed, power cycling without cleaning also significantly lowers the value. Not immediately, but within about 24 hrs. But as far as I can see, the value does not go back all the way to "when new" value.

Nismonx, 2022-04-20:
Is there a run-once self calibration instruction at boot? That would explain it.

Thread 44 (2021-12-06):

5V mention in the README

skorokithakis, 2021-12-06:
You mention in the README that the ESP8266 is 5V-tolerant, but then you mention the regulator. If you connect the 5V pad to the 5V pin of the ESP8266 board, that's not merely 5V-tolerant, it's 5V required. There's no danger of the ESP burning after a while, it'll run fine forever.

nskerl, 2021-12-17:
I was also confused by this. I have also seen other tutorials suggesting the use of a voltage divider. Perhaps there are other versions of ESP8266 board that do not have 5v pin?

dburner, 2022-01-01:
Also is this code valid for the 5V (direct link) or for the 3.3V (with voltage divider).

onshisan, 2022-01-01:
> If you connect the 5V pad to the 5V pin of the ESP8266 board, that's not merely 5V-tolerant, it's 5V required.

I understand the README to mean that the D1 is tolerant of 5V logic signals despite actually being a 3.3V logic mcu.

This project involves connecting the particle sensor to the 8266 via the IKEA PCB. The IKEA board and sensor run 5V logic, whereas [per this spec sheet the D1 is 3.3V logic for all pins/ports](https://shop.rasp.io/products/wemos-d1-mini-esp8266?variant=3485595336727).

I gather some have added a voltage divider to protect the D1, but many have not done so and (so far) found no ill effects.

skorokithakis, 2022-01-01:
@onshisan Ahh, that makes sense, thank you. Maybe the README should add the word "logic"?

Thread 47 (2021-12-20):

Not an issue, low noise mod skews sensor results by ~50%

bvkrieken, 2021-12-20:
I've implemented the low noise mod and connected the fan permanently to the 3.3v pin of the Wemos D1.
This does indeed reduce the noise significantly. But I do see a change in the sensor measurements though, they are about half as high compared to the results without the low noise mod.

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

My PM2,5 levels are to low to see whether this is an absolute reduction or a percentage reduction. Hopefully someone can give us a clear answer to that question.

bvkrieken, 2021-12-21:
To find out what the real difference in measurements is between a normal sensor and the sensor with the low noise mod, I've connected both setups to my domotica system and physically placed them right next to each other. Since the atmospheric circumstances are identical it should give me the exact difference in measurements.

bvkrieken, 2021-12-22:
After 24 hours of comparing the low noise modded sensor with the original sensor, I can conclude that the difference ratio between the two is ~1.82. So the 'real' value is the value of the low noise modded sensor times 1.82.
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

boomvalt, 2022-10-02:
This is actually a problem, because it will presumably affect the led indicator, potentially giving people a false sense of security.

Thread 48 (2022-01-01):

Can't re-configure D1 after initial deployment

onshisan, 2022-01-01:
I noticed that reconfiguration after initial deployment is a "To Do" in the readme:
>Reconfiguration of a provisioned device without having to OTAU a firmware that clears the settings would be nice.

What is the best/easiest way to do this at present (i.e., how should I OTAU firmware to clear settings)?

I have no experience with OTAU, and I presume there's a relatively simple way to accomplish this (for now) that I'm not familliar with.

I would be happy to contribute documentation if pointed in the right direction.

Aside from OTAU, I have had some success with bringing up the AP by temporarily blocking the D1's MAC address on my network and I've been playing around with flashing the firware again; however, when connected to my laptop by USB, I can see via serial monitor that the device seems to re-join the same wifi network with the previous settings (i.e., no AP and no opportunity to make SSID or MQTT config changes) after re-flashing.

onshisan, 2022-01-01:
I see this problem has been incidentally addressed in [a different issue](https://github.com/Hypfer/esp8266-vindriktning-particle-sensor/issues/20#issuecomment-950218909):
>I fixed it with erasing the Wemos completely with esptool and reinstalling the sketch:
>
>`esptool.py --port /dev/tty.usbserial-34440 erase_flash`

Closed 2022-05-24.

Thread 50 (2022-01-07):

Not Issue - I need help with code

Karelchlumecky, 2022-01-07:
Hello everyone. I have my own web communication on ESP32 and i need only take values from sensor. Am I understand right that i need only SerialCom.h library and calling on it with SerialCom::handleUart(state); and its done ? Thanks for answer have a nice day.

Thread 52 (2022-02-20):

The value does not fall below 200

tiimsvk, 2022-02-20:
Not sure how to fix incorrect display values?  He's been showing me 200-260 for some time.  And it will never go down.  I also tried to vacuum and it didn't help.

hb020, 2022-02-21:
Vacuum is not enough. I found that you need to regularly dismantle the sensor completely, and blow compressed air through the sensor (I used 3 bar, probably overkill).
This is how far I dismantle it (just unscrew everything, no need to desolder or cut glue):
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

But even that no longer works lately. Trying ultrasound cleaning now.
And even then, it takes some time for the values to drop. It seems to have some memory.

hmax42, 2022-03-08:
i had a similar problem, but i solved it by power cycling the unit
https://github.com/Hypfer/esp8266-vindriktning-particle-sensor/issues/43#issuecomment-1061440029

tiimsvk, 2022-03-08:
The complete disassembly and cleaning of the sensor also helped me. Subsequently, with the passage of time, I restarted the sensor twice.
Now, after 2 weeks, the data is still fine

hmax42, 2022-03-27:
and again i powercycled my units, see the graph from one of them:
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

Thread 53 (2022-03-01):

Web interface problem

burakcankose, 2022-03-01:
hello, first of all thanks for your development. the installation went smoothly, the sensor works fine, but the web interface is not available, when I want to change the setting, I cannot reach anywhere. I completely deleted the esp card, I reinstalled it many times, but the problem was not solved, what can I do?

fusebyte, 2022-08-19:
I cannot enter web interface too, even if i try to access it manually

AseKarlsson, 2023-02-12:
Hi, Did you solve it, I am in the same situation?

tabearu, 2023-02-12:
Were you at some point able to connect the device to your WiFi? I figured out that as soon as the WiFi connects, there's no way to change any settings, even if for example MQTT-settings are wrong. I had this issue and you can 'solve' it by removing the connection to your WiFi. This way, the esp will go back to AP-mode. Easiest solution is to turn off your WiFi until you've changed the settings. If that's not possible try wrapping a bit of aluminium foil around the esp to block the WiFi connection. Can be a bit tricky to figure out how much foil you need in order to be able to connect (e.g. with a phone) and block the WiFi but it worked for me.

AseKarlsson, 2023-02-13:
I am not able to connect to web interface at all, not a single time.
Probably due to Issue #61

Thread 54 (2022-06-18):

The sensor measure always 0 ug/mc!

MANUTx, 2022-06-18:
Hi, from some weeks I have a problem with the measurement: the sensor show always 0ug/mc... which could be the problem?
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

emanueletocci, 2023-03-09:
> I know is old, have you resolv the issue, my sensor measure always 8 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

Ciao, ti rispondo direttamente in italiano che facciamo prima... allora diciamo che sono riuscito a risolvere parzialmente, il sensore ha continuato a funzionare correttamente per qualche mese ma poi é definitivamente morto (c'é da dire che ho combinato un po di casini con le saldature).
Se hai saldato il cavetto dei dati sul pad "REST" devi provare a saldarlo direttamente al pin dati del chip presente, quello che vedi in foto.
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

Thread 55 (2022-07-17):

Embarrasingly stuck

Nukle0n, 2022-07-17:
So I set up an MQTT broker and linked it to Home Assistant, and I soldered the board in and flashed it, and ran the config from its ad-hoc network... now what? I'm seeing the device on my router but I don't know what to do next, none of the guides on MQTT broker stuff seem to explain what to do, if I should just expect it to work? I tried inputting the address of my MQTT broke both with and without port number and I don't really know what the heck to do. Do i need to broadcast a topic? What even is a topic? Should I have set something in the code before flashing it?

My apologies for ranting but this is has turned out to be a really poor example of a first time MQTT project 😅

Rclark01, 2022-08-24:
I’m stuck here too 😖

Were you able to get past this?

Nukle0n, 2022-08-24:
You need to make sure your MQTT broker is accessible, you have to set up the "listener" argument in the .conf file so it can be accessed outside of the local machine

Rclark01, 2022-08-24:
Thank you very much! I got it working this afternoon

boomvalt, 2022-10-02:
Sorry for the newbie question, but where do I find the .conf file?

Nukle0n, 2022-10-02:
> Sorry for the newbie question, but where do I find the .conf file?

If you're using HAOS there's no conf file, you just need to set up MQTT as an extension. If you're doing docker you need map a static directory to where there is a conf file.

Thread 57 (2022-08-09):

I don't have MQTT But I need help.

Therealjosephchrzempiec, 2022-08-09:
Hello, I don't have MQTT but I would like to use the sensor Is there a way to still see the sensor info without using MQTT?

Joseph

Therealjosephchrzempiec, 2022-08-13:
Hello, I still can not figure out how to get the sensor to work without mqtt. I don't have mqtt or home assistant. please someone help me to try to get the sensor to work on serial monitoring without mqtt on it?

Fbo06, 2022-09-04:
Hello, you can view the series output on the Arduino IDE

Thread 58 (2022-09-04):

Not an Issue ! juste Topic Name

Fbo06, 2022-09-04:
Hello, can someone please give me the MQTT's topic name for the PM 2.5 and for the WiFi ? thank you by advance

Fbo06, 2022-09-09:
Hello, no one have a response for me ? please help me !

TyberiusPrime, 2023-01-09:
reading the source
esp8266-vindriktning-particle-sensor/<identifier>/status
esp8266-vindriktning-particle-sensor/<identifier>/state
esp8266-vindriktning-particle-sensor/<identifier>/command

The identifier is  "VINDRIKTNING-%X", ESP.getChipId()
so you might need to find it by listening to esp8266-vindriktning-particle-sensor/#

Thread 59 (2022-10-19):

Seeing odd values on sensor UART

kieran, 2022-10-19:
I'm getting really bizarre readings from the UART...

I've tried 2 different ESP8266s (d1 mini clones) and an ESP32 (a mini32) and see the same behaviour on each. The IKEA unit appears to work normally, and the LEDs on it light up as you would expect in different atmospheres.

Have also de/re-soldered the wires a few times, powered the ESP via either 5V pin or USB. Same deal each time.

Code modifications (for logging):
```cpp
bool isValidHeader() {
  Serial.printf("Expected header: %02X %02X %02X\n", 0x16, 0x11, 0x0B);
  Serial.printf("Received header: %02X %02X %02X\n", serialRxBuf[0], serialRxBuf[1], serialRxBuf[2]);
  bool headerValid = serialRxBuf[0] == 0x16 && serialRxBuf[1] == 0x11 && serialRxBuf[2] == 0x0B;
  // ...
```

```cpp
void handleUart(particleSensorState_t& state) {
  // ...
  Serial.print("Receiving: ");
  while (sensorSerial.available()) {
    serialRxBuf[rxBufIdx] = sensorSerial.read();
    Serial.printf("%02X ", serialRxBuf[rxBufIdx]);
    rxBufIdx++;
  // ...
```

Serial output
```
Receiving: F7 Done.
Expected header: 16 11 0B
Received header: F7 00 00
Received message with invalid header.

Receiving: FF Done.
Expected header: 16 11 0B
Received header: FF 00 00
Received message with invalid header.

Receiving: 7F FB Done.
Expected header: 16 11 0B
Received header: 7F FB 00
Received message with invalid header.

Receiving: EB FF FF Done.
Expected header: 16 11 0B
Received header: EB FF FF
Received message with invalid header.

Receiving: F7 FF FF Done.
Expected header: 16 11 0B
Received header: F7 FF FF
Received message with invalid header.
```

I'm somewhat new to C++ / Arduino, would appreciate any tips re: where to look next!

Thread 60 (2023-01-21):

No mqtt topic is visible

mStirner, 2023-01-21:
I use MQTT Explorer & mosquitto broker.
However, i cant see the mqtt topic "air-sensor/sensor/particulate_matter_25m_concentration/state"
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

What do i have todo that i can see the values?
Are they values/topics only published if the hardware reading is possible.
Because my wiring is wrong i dont even see the topic?

Logging seems good to me, but there isnt any measurement either.

```
[17:18:23][C][logger:293]: Logger:
[17:18:23][C][logger:294]:   Level: DEBUG
[17:18:23][C][logger:295]:   Log Baud Rate: 0
[17:18:23][C][logger:296]:   Hardware UART: UART0
[17:18:23][C][uart.arduino_esp8266:102]: UART Bus:
[17:18:23][C][uart.arduino_esp8266:104]:   RX Pin: GPIO3
[17:18:23][C][uart.arduino_esp8266:106]:   RX Buffer Size: 256
[17:18:23][C][uart.arduino_esp8266:108]:   Baud Rate: 9600 baud
[17:18:23][C][uart.arduino_esp8266:109]:   Data Bits: 8
[17:18:23][C][uart.arduino_esp8266:110]:   Parity: NONE
[17:18:23][C][uart.arduino_esp8266:111]:   Stop bits: 1
[17:18:23][C][uart.arduino_esp8266:113]:   Using hardware serial interface.
[17:18:23][C][pm1006:017]: PM1006:
[17:18:23][C][pm1006:018]:   PM2.5 'Particulate Matter 2.5µm Concentration'
[17:18:23][C][pm1006:018]:     Device Class: 'pm25'
[17:18:23][C][pm1006:018]:     State Class: 'measurement'
[17:18:23][C][pm1006:018]:     Unit of Measurement: 'µg/m³'
[17:18:23][C][pm1006:018]:     Accuracy Decimals: 0
[17:18:23][C][pm1006:018]:     Icon: 'mdi:blur'
[17:18:23][C][pm1006:019]:   Update Interval: never
[17:18:24][C][captive_portal:088]: Captive Portal:
[17:18:24][C][mdns:103]: mDNS:
[17:18:24][C][mdns:104]:   Hostname: air-sensor
[17:18:24][C][ota:093]: Over-The-Air Updates:
[17:18:24][C][ota:094]:   Address: air-sensor.local:8266
[17:18:24][C][ota:097]:   Using Password.
[17:18:24][C][api:138]: API Server:
[17:18:24][C][api:139]:   Address: air-sensor.local:6053
[17:18:24][C][api:141]:   Using noise encryption: YES
[17:18:24][C][mqtt:065]: MQTT:
[17:18:24][C][mqtt:066]:   Server Address: [redacted]:1883 ([redacted])
[17:18:24][C][mqtt:068]:   Username: [redacted]
[17:18:24][C][mqtt:069]:   Client ID: [redacted]
[17:18:24][C][mqtt:074]:   Topic Prefix: 'air-sensor'
[17:18:24][C][mqtt:076]:   Log Topic: 'air-sensor/debug'
[17:18:24][C][mqtt:079]:   Availability: 'air-sensor/status'
[17:18:24][C][mqtt.sensor:027]: MQTT Sensor 'Particulate Matter 2.5µm Concentration':
[17:18:24][C][mqtt.sensor:031]:   State Topic: 'air-sensor/sensor/particulate_matter_25m_concentration/state'
```

config.yaml
```yml
esphome:
  name: air-sensor

esp8266:
  board: esp01_1m

# Enable logging
logger:
  baud_rate: 0

# Enable Home Assistant API
api:
  encryption:
    key: "xxxx"

ota:
  password: "xxxxx"

wifi:
  ssid: !secret wifi_ssid
  password: !secret wifi_password

  # Enable fallback hotspot (captive portal) in case wifi connection fails
  ap:
    ssid: "Air-Sensor Fallback Hotspot"
    password: "xxxx"

captive_portal:

# Example configuration entry
uart:
  rx_pin: RX
  baud_rate: 9600

sensor:
  - platform: pm1006
    pm_2_5:
      name: "Particulate Matter 2.5µm Concentration"

mqtt:
  broker: xxxx
  discovery: true
```

Board i used with a dc/dc converter for the power supply & voltage divider for the UART TX/RX pin
https://www.amazon.de/dp/B074RL7YR3?psc=1&ref=ppx_yo2ov_dt_b_product_details

mStirner, 2023-01-21:
> Are they values/topics only published if the hardware reading is possible.
My guess where right, its only visible/published after values can/have been read.

My problem was i tested it without the sensor attached... :roll_eyes: :facepalm:

```
[19:15:55][D][sensor:126]: 'Particulate Matter 2.5µm Concentration': Sending state 18.00000 µg/m³ with 0 decimals of accuracy
[19:15:57][D][pm1006:091]: Got PM2.5 Concentration: 18 µg/m³
[19:15:57][D][sensor:126]: 'Particulate Matter 2.5µm Concentration': Sending state 18.00000 µg/m³ with 0 decimals of accuracy
[19:15:59][D][pm1006:091]: Got PM2.5 Concentration: 18 µg/m³
[19:15:59][D][sensor:126]: 'Particulate Matter 2.5µm Concentration': Sending state 18.00000 µg/m³ with 0 decimals of accuracy
```

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

Looks good now and its working :)

Closed 2023-01-21.

Thread 61 (2023-02-07):

Version Questions on Library Manager

AseKarlsson, 2023-02-07:
Hi,

For Library Manager it says versions:

ArduinoOTA 1.0.3
ArduinoJSON 6.10.1
PubSubClient 2.8.0
WiFiManager 0.15.0

Does it have to be these or do newer work as well?

Thanks,
AseKarlsson

AseKarlsson, 2023-02-10:
Hi,
Can there also be info hos Libraries?
If I serach on theese I get a dosen?
And I fail to install

//AseKarlsson

AseKarlsson, 2023-02-10:
Tried with these exact versions but it fails, any help?

AseKarlsson, 2023-02-11:
Installed:
	ArduinoJSON by Benoit Blanchon, version 6.20.1
	WifiManager by tzapu, version 0.15.0
	PubSubClient by Nick OLeary, version 2.8.0

Opened the .ino file and let it create folder and copy itself into it.
Copied the following files into the newly sreated folder:
	Config.h
	SerialCom.h
	Types.h

Loaded the project and when verify:
c:\Downloads\Arduino\libraries\WhareHauoraWiFiManager/WiFiManager.h:25:24: error: 'const char HTTP_HEAD []' redeclared as different kind of entity
   25 | const char HTTP_HEAD[] PROGMEM            = "<!DOCTYPE html><html lang=\"en\"><head><meta name=\"viewport\" content=\"width=device-width, initial-scale=1, user-scalable=no\"/><title>{v}</title>";
      |                        ^~~~~~~
In file included from C:\Downloads\Arduino\esp8266-vindriktning-particle-sensor\esp8266-vindriktning-particle-sensor.ino:4:
C:\Users\XXX\AppData\Local\Arduino15\packages\esp8266\hardware\esp8266\3.1.1\libraries\ESP8266WebServer\src/ESP8266WebServer.h:47:39: note: previous declaration 'HTTPMethod HTTP_HEAD'
   47 | enum HTTPMethod { HTTP_ANY, HTTP_GET, HTTP_HEAD, HTTP_POST, HTTP_PUT, HTTP_PATCH, HTTP_DELETE, HTTP_OPTIONS };
      |                                       ^~~~~~~~~

exit status 1

Compilation error: exit status 1

Any help appreciated!
Thanks,
AseKarlsson

AseKarlsson, 2023-02-11:
Some more info after googeling other projects. If I change in WifiManagers WiFiManager.h file the line HTTP_HEAD to HTTP_HEADS it and compile. I can see the unit now on the network, but cannot connect.

AseKarlsson, 2023-02-12:
Hi,

Is this project and forum all dead?

I failed to compile the original code.
Found the HTTP_HEAD to HTTP_HEADS from other projects but they fail as well to connect to the unit as me.

Any help, would prefer MQTT before ESP Home

Thanks,
AseKarlsson

AseKarlsson, 2023-02-14:
@Hypfer, Can you please take a look if you can understand why I cannot compile?

AseKarlsson, 2023-02-14:
> Do you have a support contract?

Nope, just hoping for help :)

Hypfer, 2023-02-14:
*demanding

Thread 62 (2023-03-06):

How to See the Data in an App ?

Codebysolder, 2023-03-06:
I have the Code running OK on The ESP8266 D1 Mini in the VINDRIKTNING.
The Serial Port is streaming measurements to my IDE Serial Monitor.

What do I have to  use to see the data on an App ? (or a browser)
The Config.h is untouched, I dont know what to enter !
It has somehow managed to connect to my WiFi despite not giving it an SSID or Password.

I installed Home Assistant on my Android Tablet, it asks for a URL, I dont have one
The Blog does say this code  works with auto discovery, but no joy.

This must be a pretty basic issue, but I cant find any tutorial related to it.

Codebysolder, 2023-03-07:
Hmm, no takers.
Its a shame that for the sake of a basic tutorial on setting this up that such a complex program is likely to be abandoned.
Looking at the other Issues, I am not the only person at a loss to getting this finished.

I have done numerous other ESP projects using Blynk and Thingspeak, so I will have a go at using the  data in the serial feed to  feed Thingspeak - has anyone else done this ?

I want to use a simple manual configuration of ssid/password for the wifi, so first task is to clear out all the code around this.

I added a Piezo buzzer between port D6 and +3.3V, very useful to indicate the WiFi has connected or whatever you want.
I attach a few pics of a simple way of wiring this up using normal 1/10th  inch pitch headers, tweaked so they surface mount and then supported with epoxy resin (not hot melt). I used double sided tape to fix the board (with a 3mm spacer) with the socket available for external  connection, easy to reflash with it all screwed together.

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

Codebysolder, 2023-03-07:
After  remming out about half the code and adding in Thingspeak, its working.
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

Nismonx, 2023-03-07:
Probably worth doing some reading on MQTT....
Homeassistant, nodered....

Codebysolder, 2023-03-07:
I accept that, I did look at the mqtt site and the "quick start" seemed anything but !
I have used Thingspeak for a few projects and it works very well, I prefer it to Blynk.
The code in this project is well beyond my capability, I am not a natural programmer.

Thread 64 (2024-07-06):

Also working with the new version, VINDSTYRKA

mStirner, 2024-07-06:
Does some one have tried this project with the new version VINDSTYRKA?
https://www.ikea.com/de/de/p/vindstyrka-luftqualitaetssensor-smart-00498231/

LordPinhead, 2024-07-06:
I know from this project it was hacked at least https://github.com/oleksiikutuzov/IKEA-VINDSTYRKA/issues/1 and it has a standard sensor, at least that is what I've read. I have no Vindstyrka, otherwise, I would've tried it with Tasmota or ESPHome already.

LordPinhead, 2024-07-21:
So, FYI, I installed an ESP32 S2 board into the Sensor.
Pins: 5V GND, GPIO21 for SDA and GPIO22 SCL
Working flawlessly with Home Assistant or even standalone when you know how to Configure MQTT.
Config (api keys changed):

```
esphome:
  name: vindstyrka
  friendly_name: Vindstyrka

esp32:
  board: nodemcu-32s
  framework:
    type: arduino

logger:

api:
  encryption:
    key: "8cD8IXw54kcq43qgaH6kFaJWid3WjciK3mHVKkwdSO8="

ota:
  - platform: esphome
    password: "7d3b62f63e1417f1f07f7195ad4cc8c4"

wifi:
  ssid: !secret wifi_ssid
  password: !secret wifi_password
  domain: .your-internal-domain

  ap:
    ssid: "Supersensor Fallback Hotspot"
    password: "fallbackpw"

i2c:
  sda: 21
  scl: 22
  scan: true
  id: bus_a

sensor:
  - platform: sen5x
    id: sen54
    i2c_id: bus_a
    pm_1_0:
      name: " PM <1µm Weight concentration"
      id: pm_1_0
      accuracy_decimals: 1
    pm_2_5:
      name: " PM <2.5µm Weight concentration"
      id: pm_2_5
      accuracy_decimals: 1
    pm_4_0:
      name: " PM <4µm Weight concentration"
      id: pm_4_0
      accuracy_decimals: 1
    pm_10_0:
      name: " PM <10µm Weight concentration"
      id: pm_10_0
      accuracy_decimals: 1
    temperature:
      name: "Temperature"
      accuracy_decimals: 1
    humidity:
      name: "Humidity"
      accuracy_decimals: 0
    voc:
      name: "VOC"
      algorithm_tuning:
        index_offset: 100
        learning_time_offset_hours: 12
        learning_time_gain_hours: 12
        gating_max_duration_minutes: 180
        std_initial: 50
        gain_factor: 230
    temperature_compensation:
      offset: 0
      normalized_offset_slope: 0
      time_constant: 0
    acceleration_mode: low
    store_baseline: true
    address: 0x69
    update_interval: 10s
```

Don't solder a pinheader on, it's not enough space in the sensor case for it, solder the wires directly onto the ESP.
