Hypfer/esp8266-vindriktning-particle-sensor/(commit log)

2021-07-21 Cleanup, restructure, refactor to C++11
    * Cleanup and restructure code and add clang-format
    * Further improve code and reduce sketch size
    * Address review comments
    * Add comment for bit-shift operation
    * Fix parseState not returning which causes inf loop
    - Cleanup some other code
    * Address review comments
    * Remove clang-format
    * formatting
    * formatting
    * bump firmware version
    [Config.h, SerialCom.h, esp8266-vindriktning-particle-sensor.ino]
2021-07-21 Add checksum validation for received sensor data
2021-07-23 fix for case sensitive filesystems (#11)
2021-08-03 Remove irrelevant/wrong check for 0
    This fixes #16
    [SerialCom.h, esp8266-vindriktning-particle-sensor.ino]
